Moore-Lab/iseg-programmable-supply/hardware/hvctl/outputs/model3d/render_top.png

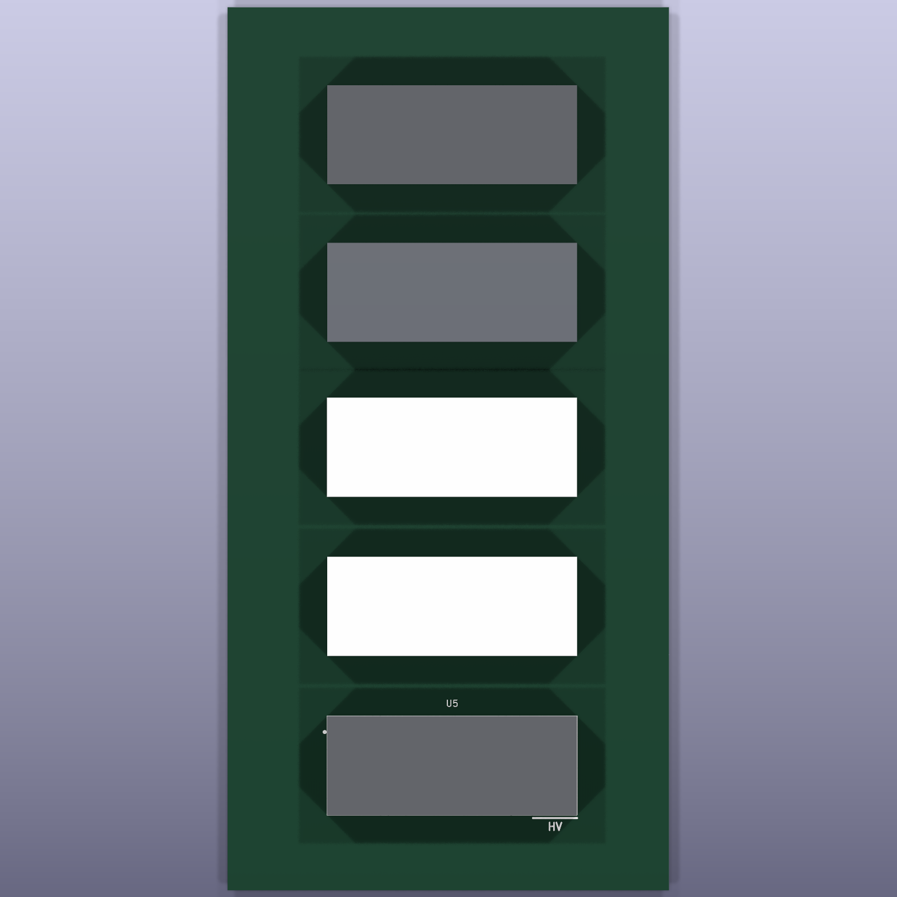
hardware/hvctl/outputs/model3d/render_top.png
