Moore-Lab/iseg-programmable-supply/hardware/hvctl/outputs/model3d/render_iso.png

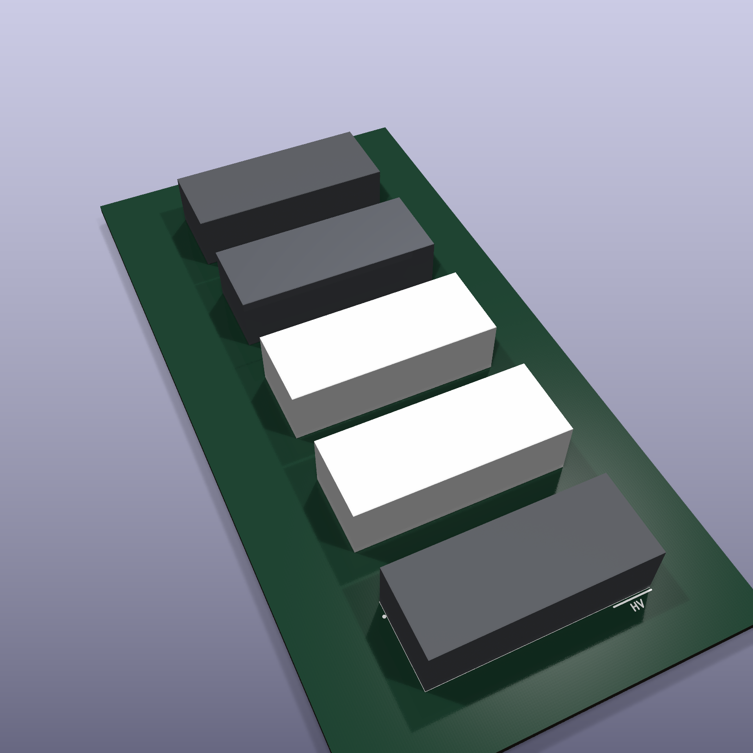
hardware/hvctl/outputs/model3d/render_iso.png
