Moore-Lab/iseg-programmable-supply/docs/DECISIONS.md

# DECISIONS — iseg Bipolar HV Controller

Single source of truth for **facts about this circuit**. Process lessons live in
`docs/PIPELINE_LOG.md`; the two never overlap.

> ## ⬛ GATE G0 IS SIGNED OFF — 2026-07-23. Read this before reading any row.
>
> The human answered on **2026-07-23**. The **five** answers are recorded verbatim at the top of
> `docs/G0_QUESTIONS.md`. In one line each:
>
> - **G0-A1 — set-and-hold with polarity changeover.** ⇒ combiner is **HV relay changeover**;
>   series-stack, diode-OR and single-module-reversing are **rejected permanently**.
> - **G0-A2 — the modules are ALREADY OWNED: `AP010504P05` + `AP010504N05`.**
>   ⇒ **1 kV / 0.5 mA / 0.5 W / 5 V in / Vref 2.5 V**, both polarities, in hand.
> - **G0-A3 — both serial AND network, FULL WRITE AUTHORITY on both.**
> - **G0-A4 — SCOPE CHANGE: switchable single-bipolar-output *or* two-independent-unipolar-outputs.**
> - **G0-A5 — MODE SELECTION IS A PHYSICAL SWITCH.** ⇒ **there is NO mode relay.** The question G0-A4
>   created (MODE-04) was answered the same day, in favour of the safest mechanism, because the
>   flexibility it appeared to cost was **illusory** — mode change requires re-cabling anyway.
>
> ### ⬛ TERMINOLOGY, adopted project-wide at G0-A5 — use the human's words
>
> **"pseudo-bipolar"** = mode 1, the single-output polarity-changeover mode. It is the honest word: the
> instrument does **not** pass smoothly through zero, it **switches** polarity.
> **"unipolar / dual-output"** = mode 2, two outputs, both energisable at once.
> Rows written before A5 say "BIPOLAR COMBINED" for mode 1; read that as **pseudo-bipolar**.
>
> ### ⚠ Three classes of row changed, and they are not the same thing
>
> 1. **`assumed-pending-G0` → `frozen`.** The answer confirmed the default. Evidence cites G0-A*.
> 2. **`assumed-pending-G0` → still assumed.** G0 did not touch it. Each such row now carries an
>    explicit *"survives G0 because…"* note. **Q3, Q5, Q6 and Q7 were not answered.**
> 3. **⛔ `WRONG`, not merely superseded.** Rows written against the **12 V / 1 W family** or against a
>    **≤600 V class** are now factually incorrect, not just out of date. They are **struck through and
>    corrected in place**, tagged `corrected-by-G0-A2`. Do not copy the struck value forward.
>
> **New status values introduced at G0:** `frozen-by-G0` · `corrected-by-G0-A2` ·
> `assumed-pending-primary-standard` (a number that no human answer can freeze — only a document can).

**Format:** `ID | decision | rationale | evidence | status`
**Status vocabulary:**
- `frozen` — decided with evidence; changing it requires a gate.
- `frozen-by-G0` — **NEW.** Was `assumed-pending-G0`; the 2026-07-23 answers resolved it. Evidence
  names which answer (G0-A1 / A2 / A3 / A4 / A5).
- `corrected-by-G0-A2` — **NEW.** The row was asserted against the 12 V / 1 W family or a ≤600 V class
  and is therefore **wrong**, not merely superseded. The wrong value is retained struck-through so it
  cannot be silently re-adopted.
- `assumed-pending-G0` — we are **proceeding on this default** (bootstrap Principle 7: *ask blocking
  unknowns once in a batch, log assumptions and proceed*). ~~The human may overturn it at G0 cheaply.~~
  **G0 has passed.** Any row still carrying this status corresponds to a question the human did **not**
  answer (Q3 output spec, Q5 safety envelope, Q6 weld, Q7 procurement) and now says so explicitly.
- `assumed-pending-primary-standard` — **NEW.** Blocked on reading a primary standards document, not on
  any human decision. Carries `[unverified-primary]` at every point of use.
- `open` — genuinely blocks; batched in `docs/G0_QUESTIONS.md` §7 "What is STILL OPEN after G0".
- `refuted` — was asserted this session and has been shown wrong. Recorded so it cannot be re-adopted.
- `corrected` — asserted, partially wrong, now restated correctly.

**Evidence tags** (`CLAUDE.md` rule 4): `[verified-run]` executed this session · `[verified-artifact]`
output on disk, inspected · `[verified-web]` read from a live page · `[recalled]` unverified.
`[skeptic×N]` means N independent adversarial sessions attacked the claim and it survived.

**MPN discipline:** every part number carries `[unverified-MPN]` until Phase 6 re-verifies it against
a live distributor page. Do not strip that tag when copying a row forward.

---

## 1. The part — iseg APS module facts

| ID | Decision | Rationale | Evidence | Status |
|---|---|---|---|---|
| PART-01 | Pin map is `1 +VIN · 2 VSET · 3 GND · 4 /ON · 5 VMON · 6 HV · 7 GND` | Everything downstream is a function of it; a wrong pin map yields a perfectly self-consistent, perfectly wrong board | Manual v2.5 Table 4, p.9, extracted verbatim. `[skeptic×3, verified-run]` — corroborated by Figure 1's own top-view panel, by the 2019 v2.1 revision, by KiCad's renderer, by `pcbnew.FootprintLoad()`, and by a third-party footprint from a board that was built | **frozen** |
| PART-02 | `/ON` is **active-LOW and floats to ON** — "LOW or n.c. → HV ON" | Inverts the reflex that "unpowered = safe". A lid switch that *opens* on lid removal is exactly backwards | Table 4 verbatim `[verified-run]` | **frozen** |
| PART-03 | `/ON` HIGH window is **>2.5 V and ≤5.5 V, for BOTH families** | Table 1's `/ON` row is a merged cell spanning the 0.5 W and 1 W columns — invisible in the text stream, visible only by rasterising the table. On a 12 V module `/ON` must **not** be driven from +VIN. **→ G0-A2 makes this benign for us:** our `+VIN` is **5 V** (PART-30), which sits inside the 2.5–5.5 V window, so ARCH-17's "pull `/ON` up to the module's own `+VIN`" is directly legal with **no dedicated ≤5.5 V rail needed**. The 12 V caveat is retained as a fact about the part, not a constraint on this board | `[verified-artifact]` raster of Table 1 at 4×; corroborated by a second agent's text extract `"5.5V ≥ V/ON >2.5V(HIGH) → VOUT =0 !"` | **frozen** |
| PART-04 | `VSET` has an internal **10 kΩ pull-up to Vref**; an **open `VSET` commands FULL SCALE** | Determines the fail-safe design of the entire set path | `[skeptic×3]`. Two independent proofs: (i) the datasheet's own `Rset = Vout·10k/(Vnom−Vout)` uniquely pins the node's Thévenin equivalent to (Vref, 10 kΩ) — pull-down and current-source hypotheses were coded and both diverge; (ii) Figure 2 rendered at native resolution shows the 10 kΩ from `VSET` up to a `REF` source whose other terminal is GND | **frozen** |
| PART-05 | **Output is internally NOT limited above Vref.** `Vset > Vref → Vout > Vnom` | The datasheet's own bolded warning. A 3.3 V rail on a 2.5 V-Vref module = 132 % of Vnom; a 5 V rail = 200 % | Table 1 verbatim, both revisions `[skeptic×3]`. Note it says "is possible" — **no ceiling is specified**, so a clamp must be designed to Vref, not to an assumed overshoot | **frozen** |
| PART-06 | `/ON` HIGH does **not** disconnect the HV path. It **grounds an internal 1 µF set node**, i.e. it commands zero inside the regulation loop | Kills the premise of any combiner that assumes "disabled module = high impedance at pin 6". Nothing internal discharges the output | Figure 2 rendered at 5–18× by **four independent agents**, same reading each time `[verified-artifact ×4]` | **frozen** |
| PART-07 | Module set-node time constant **τ = 100 kΩ × 1 µF = 100 ms**. Full-scale settle ≈460 ms (1 %) / 690 ms (0.1 %) | Dominates every timing budget in the project. Module settling ÷ PhotoMOS turn-off = 12 500×; ÷ reed changeover = 250×. **Switching speed is not a discriminator between combiners** | Figure 2 `[verified-artifact ×4]`. **INFERENCE from a figure captioned "control principle"** — iseg states no slew rate anywhere | **frozen (as an order of magnitude)** — bench-confirm before any timing budget depends on it |
| PART-08 | `VMON` is an **unbuffered ≥20 kΩ resistive tap**, not a buffered output | A 1 MΩ input divider reads 1.96 % low; 100 kΩ reads 16.7 % low — either destroys the 1 %·Vnom monitor spec. `VMON` **must** be buffered by a CMOS/FET-input unity-gain op-amp *at the pin*, before any divider or filter | Figure 2 `[verified-artifact ×3]` | **frozen** |
| PART-09 | `VMON` carries **no sign information** and is the module's own opinion. It may never be used as a polarity check or as safety feedback | Table 4 gives range only; nothing states the transfer on a negative module | `[verified-artifact]` | **frozen** |
| PART-10 | Specifications for **ripple, noise and stability are guaranteed only for `2 %·Vnom < Vout ≤ Vnom`** | Below 2 % of Vnom the output is *unspecified*, not merely worse. On a 1 kV module that is a ±20 V band no combiner can fix. **This is the fact that answers the through-zero question** | Table 1 note 1, verbatim `[verified-run ×4]` | **frozen** |
| PART-11 | Polarity is **factory-fixed** by the `P`/`N` letter in the item code | A bipolar output requires two modules (or a reversing switch). Irreversible at order time | Table 2 `[verified-run]` | **frozen** |
| PART-12 | Item-code `Inom` field decodes as **two significant digits + count of trailing zeros, in nA**; `Vnom` is three significant digits × 100 V | All eight distinct catalogue fields check out (255→2.5 mA, 125→1.2, 804→0.8, 604→0.6, 504→0.5, 505→5.0, 165→1.6, 105→1.0). Ordinary orderable code is 11 chars, e.g. `AP004125N05` | `[verified-run]` | **frozen** |
| PART-13 | `Iout` is limited to **approx. 1.5 × Inom** | Sizes every crowbar/dump resistor: `R_dump` must satisfy `1.5·Inom·R_dump < V_safe`. 1 MΩ on a 0.5 mA module gives a **750 V** "clamp" — not a clamp at all | Table 2 note 1 `[verified-run ×3]` | **frozen** |
| PART-14 | Body **39.60 × 15.70 × 11 mm**; pins **0.64 mm square**, 2.2 ±0.4 mm below body; pins 1–5 at 2.54 mm pitch (span 10.16); pins 6/7 column 34.80 mm away; pin 7 aligns with 1, pin 6 with 5 | Land pattern and enclosure | Figure 1 `[verified-artifact ×4]` | **frozen** |
| PART-15 | The body is **NOT centred** on the pin array: **+0.60 mm** long axis (toward the pins 6/7 end), **+0.23 mm** short axis (toward pin 5) | The reference footprint got this wrong by 0.6 mm | `[skeptic×3]`. Two *independent* instruments agree: arithmetic on the labelled dimensions (0.600/0.230) and pixel metrology of the artwork that never reads those labels (+0.607…+0.623 / +0.241…+0.244). One skeptic additionally traced every dimension's extension line to the feature it attaches to | **frozen** |
| PART-16 | Case is connected to GND (pins 3 and 7). Pins 3 and 7 are genuinely **redundant** grounds | Free single-fault redundancy — *if* layout routes both pins independently to the pour rather than daisy-chaining. Losing both floats a touchable steel can to an undefined HV potential | Table 4 note `[verified-run]` | **frozen** (layout rule) |
| PART-17 | Max soldering 270 °C / 10 s at 1.5 mm from case; max case temperature 120 °C | There is **no reflow profile**. The part is hand-soldered ⇒ `exclude_from_pos_files`, and a generous annular ring is justified against pad-lift on rework | Table 1 `[verified-run]` | **frozen** |
| PART-18 | Blocking capacitor **22 µF near pin +VIN**, per the datasheet's own note | The reference board had **zero** capacitors on the module supply net | Table 1 note 2 `[verified-run]` | **frozen** |
| PART-19 | v2.5 (2024-08-20) supersedes v2.1 (2019-06-03). Figures 1 and 2 and the pin map are **identical** between them; v2.5 adds monitor accuracies, soldering/case temps, humidity, and item-code revision digits | Nothing this project depends on changed between revisions | `[verified-run]` — both PDFs opened and diffed | **frozen** |
| PART-20 | **Discrepancy, flagged and deliberately unresolved:** Table 1 specifies "Current monitor accuracy 1 %·Inom" but Table 4 lists seven pins with **no current-monitor pin**, and Figure 2 shows no such node | Three non-equivalent readings (boilerplate error / customised variant / undocumented encoding). Do **not** silently resolve | `[verified-artifact ×4 — all four study agents found it independently]` | **open** → G0-6 |
| PART-21 | Until iseg answers PART-20, assume **no current readback exists**. Output-current measurement is entirely our board's problem | Conservative direction | — | **assumed-pending-G0** — **SURVIVES G0: Q7 was not answered**, nobody has emailed iseg, and PART-20 is untouched. Unchanged. |
| PART-22 | Assume `Vmon = Vref·\|Vout\|/Vnom`, positive-going on **both** polarities | Implied by the stated range and by symmetry with `Vset`, but **never stated anywhere**; the sign convention on a negative module is wholly undocumented | `[recalled/inferred]` | **assumed-pending-G0** — **SURVIVES G0**, but its resolution path changed: G0-A2 puts **both polarity variants in hand**, so the negative module's VMON sign convention is now **directly bench-measurable**. Numbers pinned by G0-A2: `Vref` = 2.5 V, `Vnom` = 1000 V ⇒ the asserted transfer is `Vmon = 2.5·\|Vout\|/1000`. Measure it. |
| PART-23 | Assume the undimensioned overhangs are exactly **3.00 mm** (pins 6/7 end) and **2.54 mm** (pin 1 side), by subtraction from 39.6 / 15.7 | The drawing prints "3" without a decimal and does not dimension the other two. Pixel measurement brackets both correctly but is ~±0.5 mm — too coarse to refine | `[verified-run]` (bracket) | **assumed-pending-G0** — **SURVIVES G0**, but is now **CALIPER-MEASURABLE** (G0-A2 consequence 4). It should not survive G1. |
| PART-24 | Assume module internal output capacitance **100 pF** (probe) to **1 nF** (topology studies). Assume internal bleeder **~20 MΩ** | iseg publishes **neither**. Every discharge time constant in this project inherits these | `[recalled]` — absence confirmed by grepping all 10 pages for `discharg\|bleed\|capacit\|slew\|ramp\|rise time\|turn-on` → **zero hits** `[verified-run]` | **assumed-pending-G0** — **SURVIVES G0** (no answer bears on it) — but **bench-measure before G1**, now genuinely possible per G0-A2. `G0_QUESTIONS.md` O-2. |
| PART-25 | Assume module restart time after `+VIN` re-application **≈150 ms**, and ramp **≈100 ms** | Undocumented. These are two of the four numbers that set the changeover dead-band | `[recalled]` | **assumed-pending-G0** — **SURVIVES G0** — **bench-measure**, now possible (G0-A2). Note G0-A4 adds a *third* consumer of this number: the **mode-change** dwell, not just the polarity changeover. |
| PART-26 | The module is operated with **GND at board ground** — not floated, not stacked | ~~Assumed because~~ **Now settled:** the only topologies that required a floating module or a floating case were `series-stack-driven-midpoint` Variant A and `single-module-polarity-reversing-relay`, and **G0-A1 rejects both permanently**. The relay-changeover topology never floats a module. The original caution stands as the reason not to revisit it: no isolation voltage, no dielectric-strength figure, no GND-to-earth rating is published anywhere, and **absence of a rating is not permission** | `[verified-run]` (absence confirmed) + **G0-A1** | **frozen-by-G0** (A1) |
| PART-27 | **Reverse voltage tolerance of an OFF module's HV pin is UNKNOWN and unpublished** | ~~Decides whether opposite-polarity diode-OR is legal at all~~ **— that role is gone: G0-A1 rejects diode-OR outright (TOPO-02/03).** What survives is the *bounding* role: what an **open combiner contact** may present. In the adopted topology the deselected module's HV pin is clamped to its own bleed by the relay's **NC** contact, so it is held near ground rather than exposed to the opposite polarity — the 2 kV differential is held **across the open contacts**, not across a module. **G0-A4 does not change this**: in dual-unipolar mode each module sits on its own node and never sees the other's polarity | `[verified-run]` (absence) + **G0-A1** | **open** — still a question for iseg (`G0_QUESTIONS.md` O-6), but **no longer topology-deciding** |

### 1.1 The module, as owned — frozen at G0-A2

The human owns **`AP010504P05`** and **`AP010504N05`**. These rows replace every "which class?" conditional
in this repository. Decode per PART-12: `AP` · `010` = 1 kV · `504` = 0.5 mA · `P`/`N` · `05` = 5 V in.

| ID | Decision | Rationale | Evidence | Status |
|---|---|---|---|---|
| PART-28 | **The parts are `AP010504P05` (positive) and `AP010504N05` (negative), one of each, IN HAND.** `Pnom` = 0.5 W | Not a selection — a fact. The item code encodes voltage class *and* polarity and both are irreversible at order time (PART-11); here both are already spent | **G0-A2**, human statement *"we have the aps10504 (both negative and positive polarity)"*, decoded against Table 2/Table 3 v2.5 using PART-12 `[verified-run]` | **frozen-by-G0** (A2) |
| PART-29 | **`Vnom` = 1000 V per module; `Inom` = 0.5 mA; `Iout` ≤ ≈1.5 × Inom = 0.75 mA** | The bipolar output is −1 kV … +1 kV, **one polarity at a time in mode 1** and **both simultaneously in mode 2** (MODE-01). Every clearance, bleed, divider and dump number in the repo was already sized against exactly this case (ARCH-26) and therefore stands unchanged | **G0-A2** + PART-13 | **frozen-by-G0** (A2) |
| PART-30 | ⛔ **`Vin` = 5 V (range 4.5–5.5 V). This is the 0.5 W / 5 V family. NOT 12 V.** `Iin` < 5 mA at Vout=0 · < 25 mA at Vnom no load · **< 180 mA at Vnom loaded** | **Every "12 V family" row in this repo is now WRONG, not superseded.** There is no 12 V module rail on this board. A 12 V rail may still exist *for relay coils* — see TOPO-08 — but it is no longer a module supply and must not be conflated with one | **G0-A2** | **frozen-by-G0** (A2) |
| PART-31 | ⛔ **`Vref` = 2.5 V ±1 %. `Vset` and `Vmon` full scale = 0 … 2.5 V. NOT 5 V.** | This is the single most consequential number G0 produced. See PART-33 | **G0-A2** | **frozen-by-G0** (A2) |
| PART-32 | **Ripple/noise: typ <10 mVpp, max <30 mVpp (f>10 Hz), <5 mVpp (f>2 kHz) — GUARANTEED ONLY for `2 %·Vnom < Vout ≤ Vnom`, i.e. only above 20 V.** Below 20 V the output is **UNSPECIFIED, not merely worse** | PART-10 stated the clause; G0-A2 makes it numeric. **Wherever a low-end spec is quoted anywhere in this project, this sentence must be quoted with it.** Note also that **nothing below 10 Hz is specified at all** — and for a DC bias read on a DMM, sub-10 Hz wander *is* the measurement | Table 1 note 1 `[verified-run ×4]` + **G0-A2** | **frozen-by-G0** (A2) |
| PART-33 | ⬛ **THE 3.3 V HAZARD IS REAL AND LOAD-BEARING. The hardware `VSET` clamp is a PRIMARY SAFETY ELEMENT of this design, not a refinement, and gets its own verification.** | Session 1 recommended the 1 W / 12 V family *specifically* because Vref = 5 V is immune to a 5 V logic rail (`G0_QUESTIONS.md` Q2). **G0-A2 answered the other way, so the hazard that recommendation existed to avoid is now the design condition.** Three module facts compose: (i) Vref = 2.5 V vs a 3.3 V MCU ⇒ a logic fault, a mis-set DAC reference, or a floating node pulled to 3.3 V commands **3.3/2.5 = 132 % ⇒ ≈1320 V**, on an input the datasheet says is *"internally not limited"* with **no stated ceiling** (PART-05); (ii) the internal 10 kΩ pull-up to Vref means an **open `VSET` commands FULL SCALE** (PART-04); (iii) `/ON` is active-low so a **floating `/ON` turns HV ON** (PART-02). **Composed, the module's un-driven default state is ENERGISED AT OVER-RANGE.** | **G0-A2** + PART-02/04/05 | **frozen-by-G0** (A2) |
| PART-34 | **Adjustment accuracy ±1 % = 10 V; voltage-monitor accuracy 1 %·Vnom = 10 V on VMON** | Sets the disagreement-trip arithmetic (ARCH-23) and is the reason no open-loop accuracy better than 1 % is obtainable (ARCH-01) | **G0-A2** + Table 1 | **frozen-by-G0** (A2) |

---
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
