Moore-Lab/iseg-programmable-supply/docs/ENVIRONMENT.md

# ENVIRONMENT — Phase 0 proof

**Date:** 2026-07-23 · **Machine:** Windows 11 Home 10.0.26200 · **Gate: MET.**

The bootstrap defines the Phase 0 gate as *"the throwaway board produces gerbers"*. It does.
`hardware/phase0_env_proof/` holds a two-resistor board driven end-to-end: schematic → ERC →
netlist → PCB → zone fill → DRC → PDF → SVG → 3D render → **gerbers + drill**.

> **Provenance note.** The Phase-0 agent in the session-1 workflow died mid-run on an API
> transport error, after writing the generators and getting as far as ERC/netlist. The
> remaining links (fill, DRC, gerbers, drill, render, and this file) were executed directly
> by the orchestrator. Every fact below carries the instrument that produced it. This file
> supersedes the "REFUTED #2 / Phase 0 gate not met" entry in `STATUS.md` §1.3, which was
> correct when written.

---

## 1. Verified stack

| Thing | Value | How verified |
|---|---|---|
| `kicad-cli` | **10.0.3** | `kicad-cli --version` `[verified-run]` |
| KiCad Python | **3.11.5** (MSC v.1944 64-bit), built 2026-01-23 | `python.exe -c "import sys;print(sys.version)"` `[verified-run]` |
| `pcbnew` module | **10.0.3** | `pcbnew.GetBuildVersion()` `[verified-run]` |
| Schematic schema | **`(version 20260306)`** | `kicad-cli sch upgrade --force` on a copied demo — see the correction note below `[verified-run]` |
| Board / footprint schema | **`(version 20260206)`** | what `pcbnew` and `fp upgrade` actually write `[verified-artifact]` |
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
