Moore-Lab/iseg-programmable-supply/docs/G0_QUESTIONS.md

# ⬛⬛ GATE G0 — **ANSWERED AND SIGNED OFF, 2026-07-23** ⬛⬛

> **STATUS: CLOSED.** The human answered on **2026-07-23**. Everything in the four boxes below is a
> **FROZEN fact**. The questions and all of the analysis beneath them are **retained deliberately** —
> they are the record of *why* each answer matters and what each answer costs. Do not delete them, and
> do not re-litigate an answered question.
>
> **FIVE answers, not three.** The human gave three answers to the batched questions, then **added a
> fourth item that is a scope change, not an answer** (A4), then **answered the question A4 itself
> created** (A5 — how the mode is selected). Treat A4 as a first-class requirement and A5 as a
> **frozen design decision**, not a recommendation.
>
> **Three of the seven questions remain UNANSWERED** (Q3 output spec, Q5 safety envelope, Q6
> weld-prevention-vs-detection) plus Q7 (procurement). Those proceed on the §6 defaults and stay
> flagged. See §7 "What is still open after G0" at the foot of this document.
>
> ### ⬛ TERMINOLOGY — the human's words, adopted project-wide (G0-A5)
>
> | Use this | For | Never write |
> |---|---|---|
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
