Moore-Lab/iseg-programmable-supply/hardware/hvctl/outputs/model3d/render_bottom.png

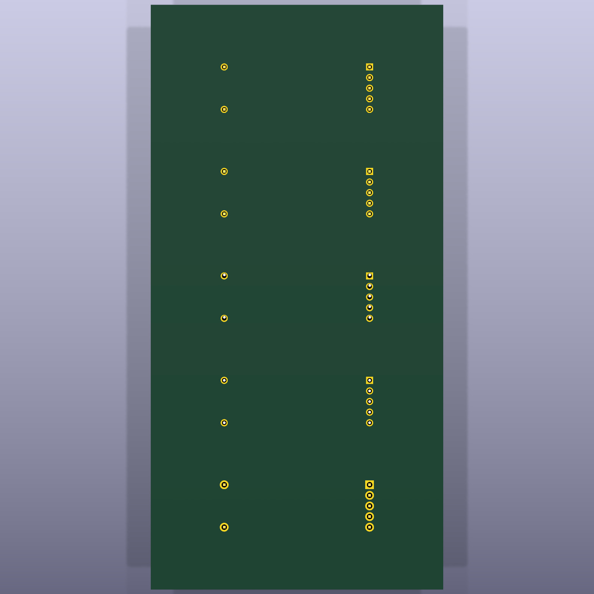
hardware/hvctl/outputs/model3d/render_bottom.png
