Moore-Lab/iseg-programmable-supply/hardware/phase0_env_proof/outputs/render_top.png

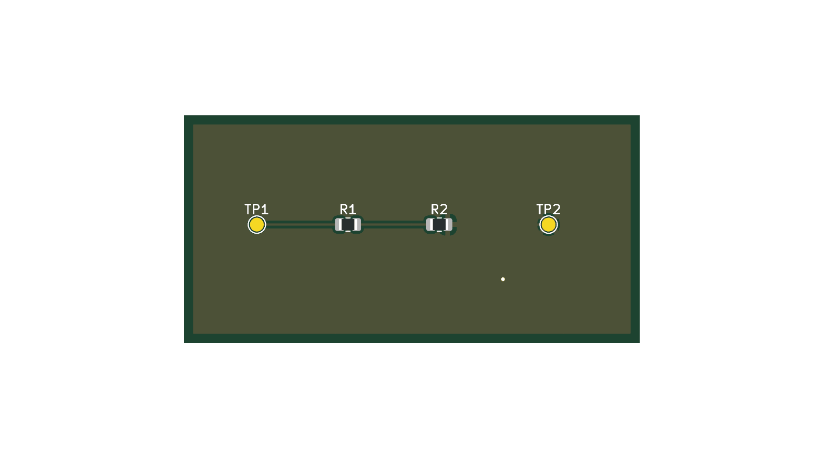
hardware/phase0_env_proof/outputs/render_top.png
