Moore-Lab/iseg-programmable-supply/hardware/phase0_env_proof/outputs/env_proof_sch.pdf

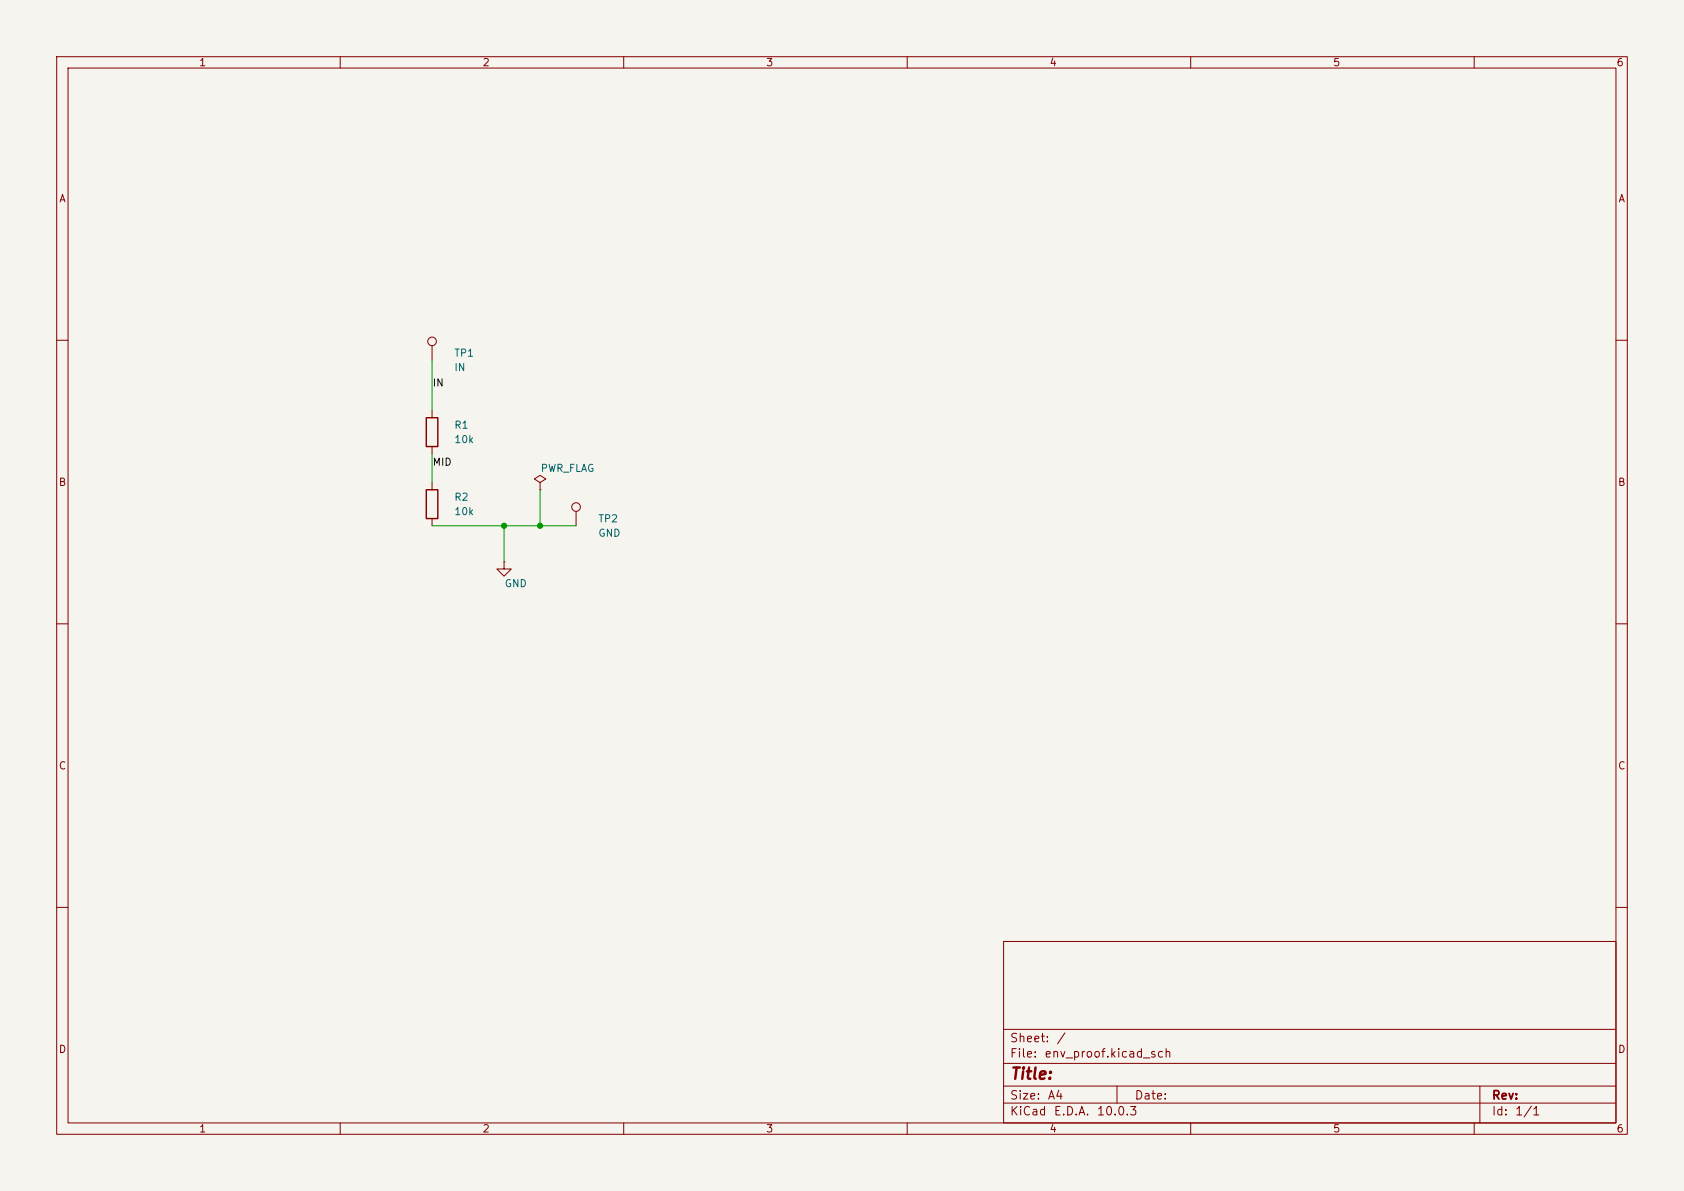
[picture p5: page 1]

Size: A4 | Rev:
KiCad E.D.A. 10.0.3 | Id: 1/1
