Moore-Lab/iseg-programmable-supply/hardware/phase0_env_proof/env_proof.kicad_pcb

## KiCad design hardware/phase0_env_proof/env_proof.kicad_pcb (2026-07-23)

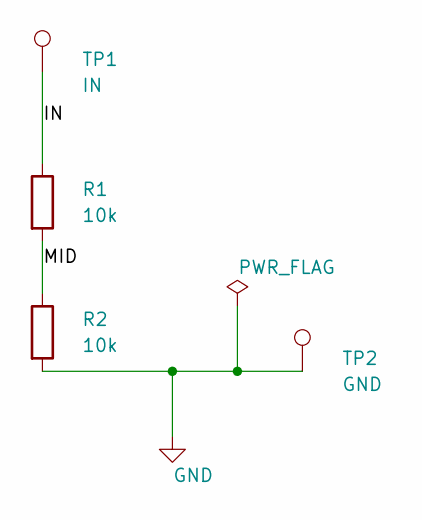
[picture p6: schematic env_proof.kicad_sch]

Parts:
R1, R2: 10k; R_0805_2012Metric
TP1: IN; TestPoint_Pad_D1.5mm
TP2: GND; TestPoint_Pad_D1.5mm

Connections:
/IN: R1.1, TP1.1
/MID: R1.2, R2.1
GND: R2.2, TP2.1

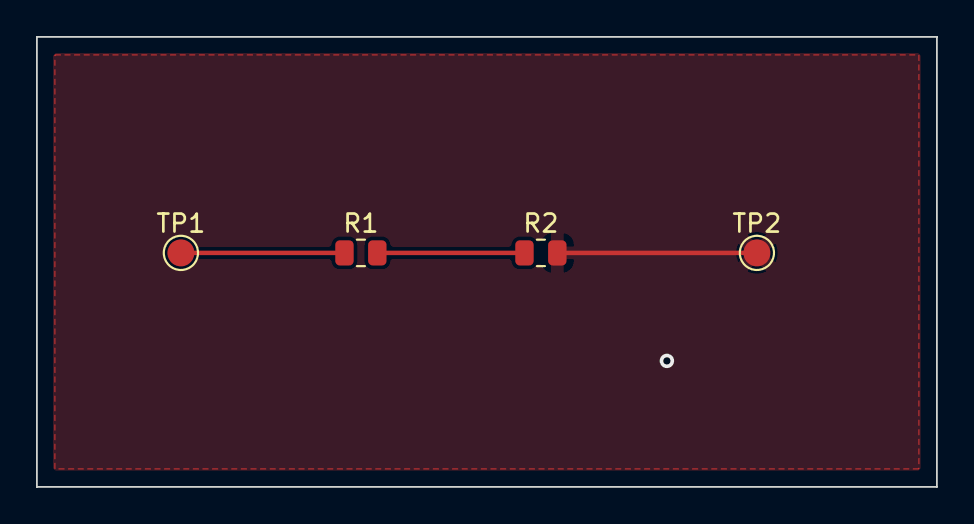
[picture p7: board env_proof.kicad_pcb from above]

Board: 2 copper layers, 50.0 x 25.0 mm, 4 parts (0 on the bottom side), 3 nets.
